dbdq/arduino-trigger/pin_layout/ArduinoMicro_PortB.png

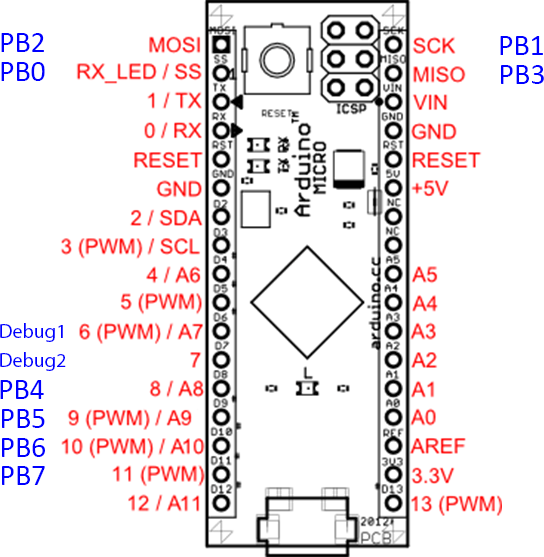
pin_layout/ArduinoMicro_PortB.png
