dbdq/arduino-trigger/case_instruction/CNBI_usb2parallel_Box v2/CNBI usb2parallel_Box v2_top_logo.stl

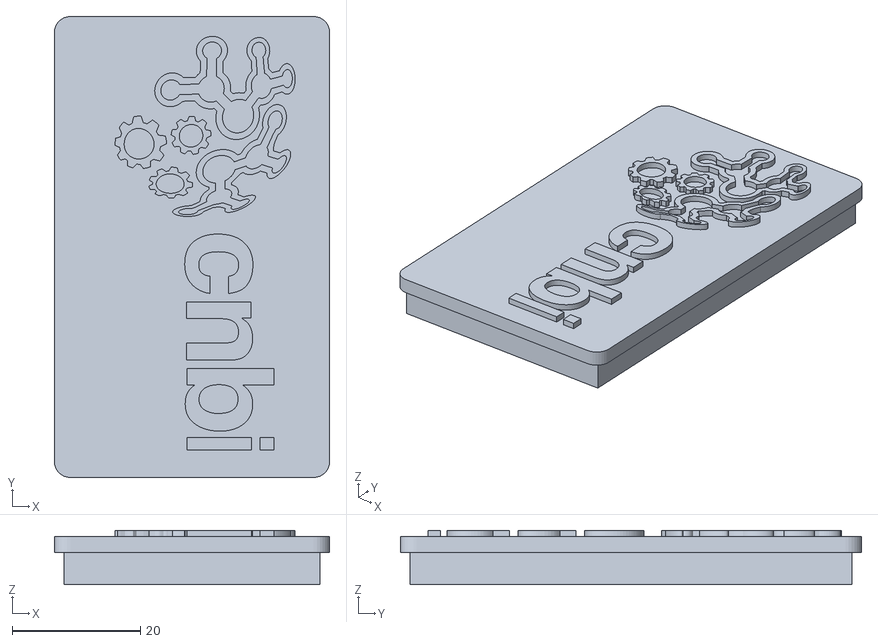
[picture p2: CAD file, 2022-07-11]
case_instruction/CNBI_usb2parallel_Box v2/CNBI usb2parallel_Box v2_top_logo.stl
43.0 x 72.0 x 8.50
