dbdq/arduino-trigger/case_instruction/CNBI_usb2parallel_Box v2/CNBI usb2parallel_Box v2_bottom.stl

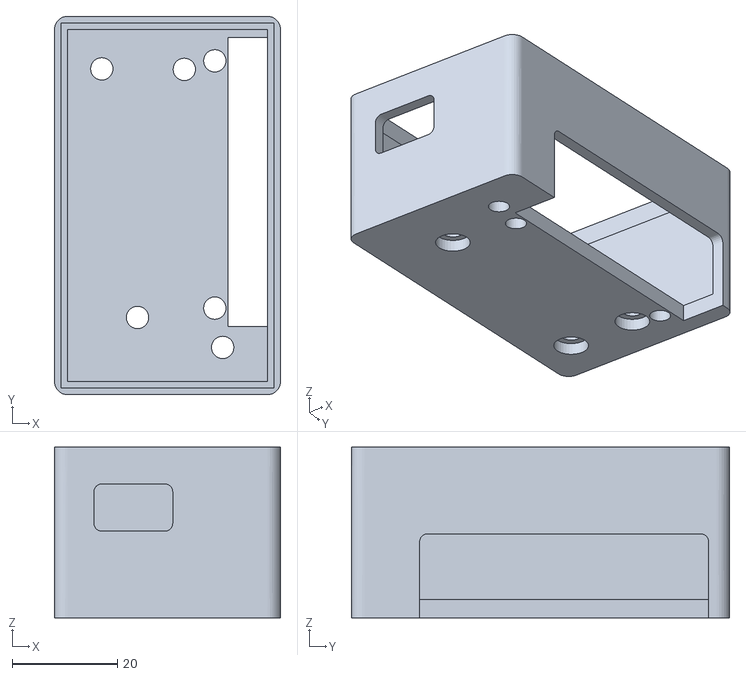
[picture p3: CAD file, 2022-07-11]
case_instruction/CNBI_usb2parallel_Box v2/CNBI usb2parallel_Box v2_bottom.stl
43.0 x 72.0 x 32.5
