dbdq/arduino-trigger/case_instruction/arduino_case.pdf

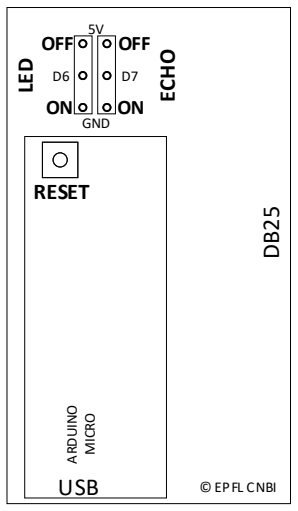
[picture p6: figure]
USB; ARDUINO; MICRO; GND; OFF; LED; ECHO; © EPFL CNBI; RESET
