dbdq/arduino-trigger/python/python_client.py

from __future__ import print_function, division

"""
Send trigger events to parallel port.

See sample code at the end.

Kyuhwa Lee, 2014
Swiss Federal Institute of Technology Lausanne (EPFL)

"""

import neurodecode.utils.pycnbi_utils as pu
import neurodecode.utils.q_common as qc
import pylsl
import threading
import os
import sys
import ctypes
import time
from builtins import input, bytes

class Trigger(object):
    """
    Supported device types:
     'Arduino': CNBI Arduino trigger
     'USB2LPT': Commercial USB2LPT adapter
     'DESKTOP': Desktop native LPT
     'SOFTWARE': Software trigger
     'FAKE': Mock trigger device for testing

    When using USB2LPT, the port number (e.g. 0x378) can be searched automatically.
    When using Desktop's LPT, the port number must be specified during initialization.

    Software trigger writes event information into a text file with LSL timestamps, which
    can be later added to fif. This file will be automatically saved and closed when Ctrl+C is
    pressed or terminal window is closed (or killed for whatever reason).

    The asynchronous function signal(x) sends 1-byte integer value x and returns immediately.
    It schedules to send the value 0 at the end of the signal length.

    To use with USB2LPT, download the driver from:
    https://www-user.tu-chemnitz.de/~heha/bastelecke/Rund%20um%20den%20PC/USB2LPT/index.en.htm

    I've made a C++ library to send commands to LPTx using standard Windows API.
    Use LptControl64.dll for 64 bit Python and LptControl32.dll for 32 bit Python.

    Some important functions:
    int init(duration)
        Returns False if error, True if success.
        Duration unit: msec

    void signal(value)
        Sends the value to the parallel port and sets to 0 after a set period.
        The value shuold be an integer in the range of 0-255.
    """
    def __init__(self, lpttype='USB2LPT', portaddr=None, verbose=True):
        self.evefile = None
        self.lpttype = lpttype
        self.verbose = verbose

        if self.lpttype in ['USB2LPT', 'DESKTOP']:
            if self.lpttype == 'USB2LPT':
                if ctypes.sizeof(ctypes.c_voidp) == 4:
                    dllname = 'LptControl_USB2LPT32.dll'  # 32 bit
                else:
                    dllname = 'LptControl_USB2LPT64.dll'  # 64 bit
                if portaddr not in [0x278, 0x378]:
                    self.print('Warning: LPT port address %d is unusual.' % portaddr)

            elif self.lpttype == 'DESKTOP':
                if ctypes.sizeof(ctypes.c_voidp) == 4:
                    dllname = 'LptControl_Desktop32.dll'  # 32 bit
                else:
                    dllname = 'LptControl_Desktop64.dll'  # 64 bit
                if portaddr not in [0x278, 0x378]:
                    self.print('Warning: LPT port address %d is unusual.' % portaddr)

            self.portaddr = portaddr
            search = []
            search.append(os.path.dirname(__file__) + '/' + dllname)
            search.append(os.path.dirname(__file__) + '/libs/' + dllname)
            search.append(os.getcwd() + '/' + dllname)
            search.append(os.getcwd() + '/libs/' + dllname)
            for f in search:
                if os.path.exists(f):
                    dllpath = f
                    break
            else:
                self.print('ERROR: Cannot find the required library %s' % dllname)
                raise RuntimeError

            self.print('Loading %s' % dllpath)
            self.lpt = ctypes.cdll.LoadLibrary(dllpath)

        elif self.lpttype == 'ARDUINO':
            import serial, serial.tools.list_ports
            BAUD_RATE = 115200

            # portaddr should be None or in the form of 'COM1', 'COM2', etc.
            if portaddr is None:
                arduinos = [x for x in serial.tools.list_ports.grep('Arduino')]
                if len(arduinos) == 0:
                    print('No Arduino found. Stop.')
                    sys.exit()

                for i, a in enumerate(arduinos):
                    print('Found', a[0])
                try:
                    com_port = arduinos[0].device
                except AttributeError: # depends on Python distribution
                    com_port = arduinos[0][0]
            else:
                com_port = portaddr

            self.ser = serial.Serial(com_port, BAUD_RATE)
            time.sleep(1)  # doesn't work without this delay. why?
            print('Connected to %s.' % com_port)

        elif self.lpttype == 'SOFTWARE':
            import neurodecode.utils.cnbi_lsl as cnbi_lsl
            from neurodecode.stream_receiver.stream_receiver import StreamReceiver
            self.print('Using software trigger')

            # get data file location
            LSL_SERVER = 'StreamRecorderInfo'
            inlet = cnbi_lsl.start_client(LSL_SERVER)
            fname = inlet.info().source_id()
            if fname[-4:] != '.pcl':
                self.print('ERROR: Received wrong record file name format %s' % fname)
                sys.exit(-1)
            evefile = fname[:-8] + '-eve.txt'
            eveoffset_file = fname[:-8] + '-eve-offset.txt'
            self.print('Event file is: %s' % evefile)
            self.evefile = open(evefile, 'a')

            # check server LSL time server integrity
            self.print("Checking LSL server's timestamp integrity for logging software triggers.")
            amp_name, amp_serial = pu.search_lsl()
            sr = StreamReceiver(window_size=1, buffer_size=1, amp_serial=amp_serial, eeg_only=False, amp_name=amp_name)
            local_time = pylsl.local_clock()
            server_time = sr.get_window_list()[1][-1]
            lsl_time_offset = local_time - server_time
            with open(eveoffset_file, 'a') as f:
                f.write('Local time: %.6f, Server time: %.6f, Offset: %.6f\n' % (local_time, server_time, lsl_time_offset))
            self.print('LSL timestamp offset (%.3f) saved to %s' % (lsl_time_offset, eveoffset_file))

        elif self.lpttype == 'FAKE' or self.lpttype is None or self.lpttype is False:
            self.print('WARNING: Using a fake trigger.')
            self.lpttype = 'FAKE'
            self.lpt = None

        else:
            self.print('ERROR: Unknown LPT port type %s' % lpttype)
            sys.exit(-1)

    def __del__(self):
        if self.evefile is not None and not self.evefile.closed:
            self.evefile.close()
            self.print('Event file saved.')
            sys.stdout.flush()

    def print(self, *args):
        qc.print_c('[pyLptControl] ', color='w', end='')
        print(*args)

    def init(self, duration):
        if self.lpttype == 'SOFTWARE':
            self.print('>> Ignoring delay parameter for software trigger')
            return True
        elif self.lpttype == 'FAKE':
            return True
        else:
            self.delay = duration / 1000.0

            if self.lpttype in ['DESKTOP', 'USB2LPT']:
                if self.lpt.init() == -1:
                    self.print('Connecting to LPT port failed. Check the driver status.')
                    self.lpt = None
                    return False

            self.action = False
            self.offtimer = threading.Timer(self.delay, self.signal_off)
            return True

    # write to software trigger
    def write_event(self, value):
        assert self.lpttype == 'SOFTWARE'
        self.evefile.write('%.6f\t0\t%d\n' % (pylsl.local_clock(), value))
        return True

    # set data
    def set_data(self, value):
        if self.lpttype == 'SOFTWARE':
            self.print('>> set_data() not supported for software trigger.')
            return False
        elif self.lpttype == 'FAKE':
            self.print('FAKE trigger value', value)
            return True
        else:
            if self.lpttype == 'USB2LPT':
                self.lpt.setdata(value)
            elif self.lpttype == 'DESKTOP':
                self.lpt.setdata(self.portaddr, value)
            elif self.lpttype == 'ARDUINO':
                self.ser.write(bytes([value]))
            else:
                raise RuntimeError('Wrong trigger device')

    # sends data and turn off after delay
    def signal(self, value):
        if self.lpttype == 'SOFTWARE':
            if self.verbose is True:
                self.print('Sending software trigger', value)
            return self.write_event(value)
        elif self.lpttype == 'FAKE':
            self.print('Sending FAKE trigger signal', value)
            return True
        else:
            if self.offtimer.is_alive():
                self.print('Warning: You are sending a new signal before the end of the last signal. Signal ignored.')
                self.print('self.delay=%.1f' % self.delay)
                return False
            self.set_data(value)
            if self.verbose is True:
                self.print('Sending', value)
            self.offtimer.start()
            return True

    # set data to zero (all bits off)
    def signal_off(self):
        if self.lpttype == 'SOFTWARE':
            return self.write_event(0)
        elif self.lpttype == 'FAKE':
            self.print('FAKE trigger off')
            return True
        else:
            self.set_data(0)
            self.offtimer = threading.Timer(self.delay, self.signal_off)

    # set pin
    def set_pin(self, pin):
        if self.lpttype == 'SOFTWARE':
            self.print('>> set_pin() not supported for software trigger.')
            return False
        elif self.lpttype == 'FAKE':
            self.print('FAKE trigger pin', pin)
            return True
        else:
            self.set_data(2 ** (pin - 1))


class MockTrigger(object):
    def __init__(self):
        self.print('*' * 50)
        self.print(' WARNING: MockTrigger class is deprecated.')
        self.print("          Use Trigger('FAKE') instead.")
        self.print('*' * 50 + '\n')

    def init(self, duration=100):
        self.print('Mock Trigger ready')
        return True

    def print(self, *args):
        print('[pyLptControl] ', end='')
        print(*args)

    def signal(self, value):
        self.print('FAKE trigger signal', value)
        return Trues

    def signal_off(self):
        self.print('FAKE trigger value 0')
        return True

    def set_data(self, value):
        self.print('FAKE trigger value', value)
        return True

    def set_pin(self, pin):
        self.print('FAKE trigger pin', pin)
        return True


# set 1 to each bit and rotate from bit 0 to bit 7
def test_all_bits(trigger):
    for x in range(8):
        val = 2 ** x
        trigger.signal(val)
        #trigger.set_data(val)
        print(val)
        time.sleep(1)

# sample test code
if __name__ == '__main__':
    trigger = Trigger('ARDUINO')
    #trigger = Trigger('ARDUINO', 'COM5')
    if not trigger.init(500):
        print('LPT port cannot be opened. Using mock trigger.')
        trigger = MockTrigger()

    # Christmas tree mode (set 1 bit-by-bit)
    #test_all_bits(trigger)

    print('Type quit or Ctrl+C to finish.')
    while True:
        val = input('Trigger value? ')
        if val.strip() == '':
            continue
        if val == 'quit':
            break
        if 0 <= int(val) <= 255:
            trigger.signal(int(val))
            print('Sent %d' % int(val))
        else:
            print('Ignored %s' % val)
