dbdq/arduino-trigger/(commit log)

2016-05-10 pin layout update
2016-05-11 pin layout added
    [ArduinoMicro_pin_mapping.xlsx]
2016-05-11 debug pin change
2017-11-21 PCB added
    [PCB1_Copper_Signal_Bot.gbr, PCB1_Copper_Signal_Top.gbr, PCB1_Drawing_1.gbr, PCB1_Drillmap_1.gbr, PCB1_Keep-out.gbr, PCB1_Legend_Bot.gbr, PCB1_Legend_Top.gbr, PCB1_Mechanical_1.gbr]
2018-03-27 case instruction for 3d printer
2022-07-11 add Arduino box design
    [CNBI usb2parallel_Box v2_bottom.stl, CNBI usb2parallel_Box v2_top.stl, CNBI usb2parallel_Box v2_top_logo.stl]
